kedube/monitoring-pcb/hardware/smoke_bridge/previews/bottom.png

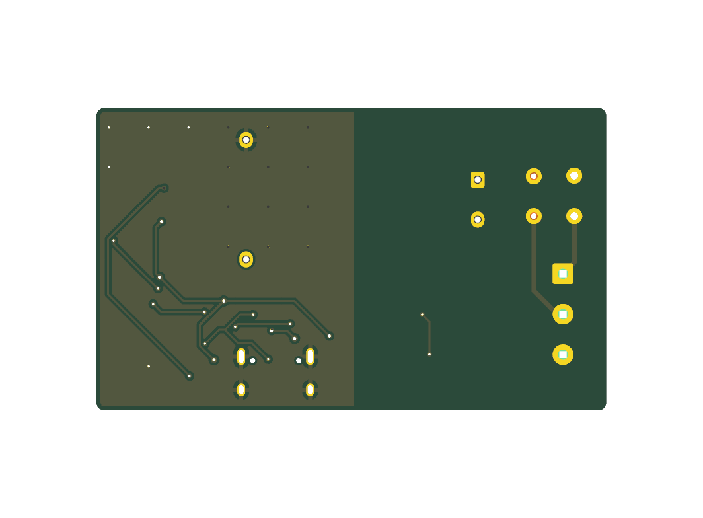
hardware/smoke_bridge/previews/bottom.png
