kedube/monitoring-pcb/hardware/smoke_bridge/previews/review.png

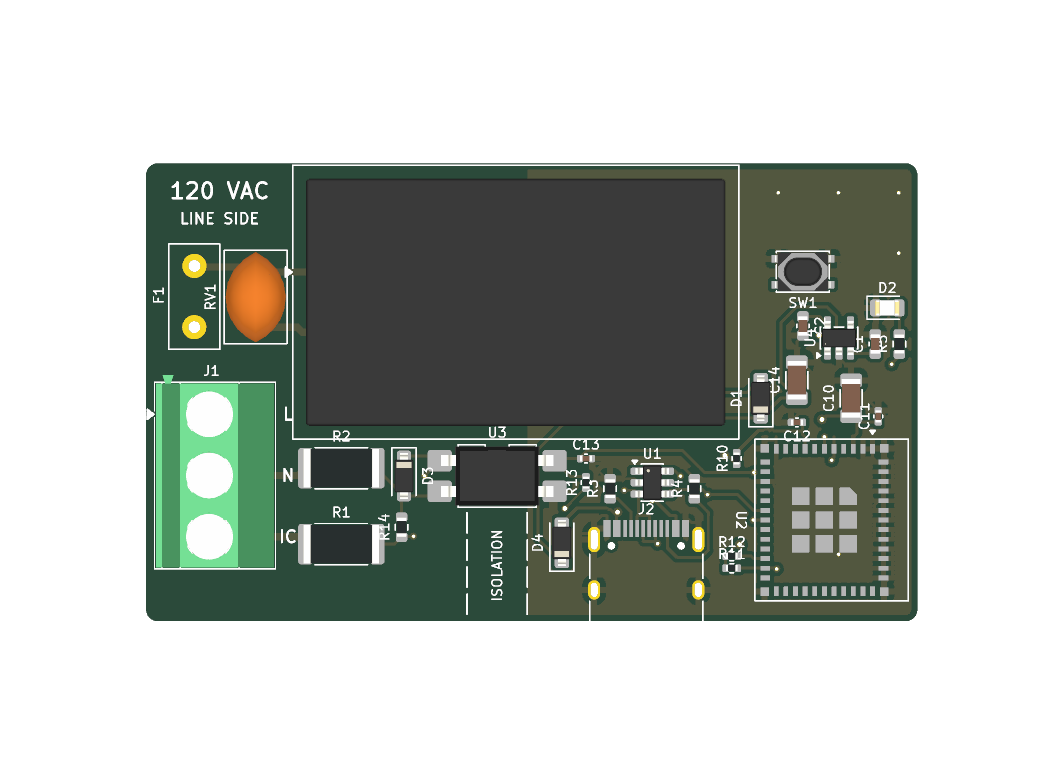
hardware/smoke_bridge/previews/review.png
