kedube/monitoring-pcb/hardware/smoke_bridge/previews/schematic.png

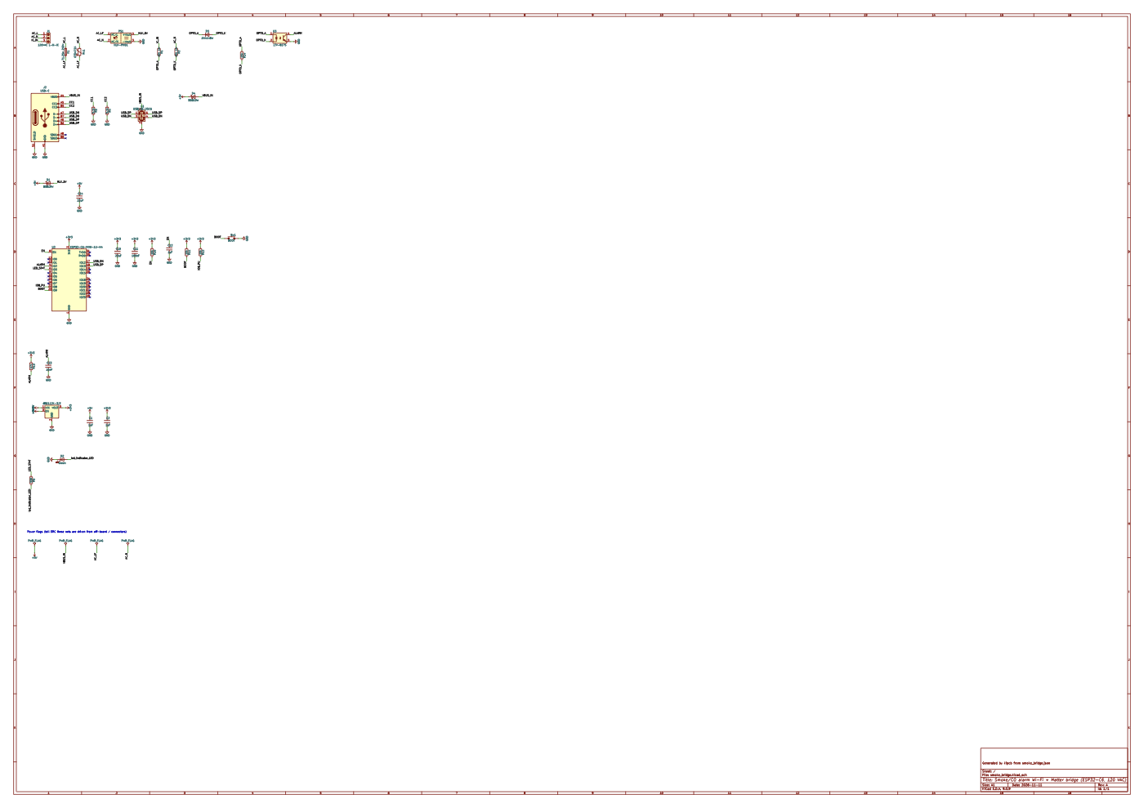
hardware/smoke_bridge/previews/schematic.png
