kedube/monitoring-pcb/hardware/smoke_bridge/fab/smoke_bridge-bom.csv

Comment | Designator | Footprint | LCSC Part # | MPN | Qty
100nF | C11 | C_0402_1005Metric | C307331 |  | 1
1uF | C12 | C_0402_1005Metric | C52923 |  | 1
10nF | C13 | C_0402_1005Metric | C15195 |  | 1
1uF | C1,C2 | C_0603_1608Metric | C15849 |  | 2
22uF | C10,C14 | C_1206_3216Metric | C12891 |  | 2
Green | D2 | LED_0805_2012Metric | C2297 |  | 1
1N4148W | D3 | D_SOD-123 | C81598 |  | 1
B5819W | D1,D4 | D_SOD-123 | C8598 |  | 2
T1.25A 250V | F1 | Fuse_Littelfuse_395Series | C354901 | 2010T1.25A250V | 1
120VAC L-N-IC | J1 | Terminal_3P_5.08_L-N-IC | C430602 | DB128L-5.08-3P-BK-S | 1
USB-C | J2 | USB_C_Receptacle_HRO_TYPE-C-31-M-12 | C165948 |  | 1
HLK-PM01 | PS1 | HLK-PM01_IsolationBarrier | C209903 |  | 1
330 | R5 | R_0603_1608Metric | C23138 |  | 1
47k | R13 | R_0402_1005Metric | C25792 |  | 1
15k | R14 | R_0603_1608Metric | C22809 |  | 1
10k 1W | R1,R2 | R_2512_6332Metric | C25718 |  | 2
10k | R10,R11,R12 | R_0402_1005Metric | C25744 |  | 3
5.1k | R3,R4 | R_0603_1608Metric | C23186 |  | 2
07D471K | RV1 | C_Disc_D7.5mm_W5.0mm_P5.00mm | C49072860 |  | 1
BOOT | SW1 | SW_SPST_PTS810 | C221895 | PTS810SJG250SMTRLFS | 1
USBLC6-2SC6 | U1 | SOT-23-6 | C7519 |  | 1
ESP32-C6-MINI-1U-H4 | U2 | ESP32-C6-MINI-1U | C20627095 |  | 1
LTV-817S | U3 | SMDIP-4_W9.53mm | C109227 | LTV-817S-TA1-C | 1
AP2112K-3.3 | U4 | SOT-23-5 | C51118 |  | 1
