kedube/monitoring-pcb/hardware/smoke_bridge/fab/smoke_bridge.step

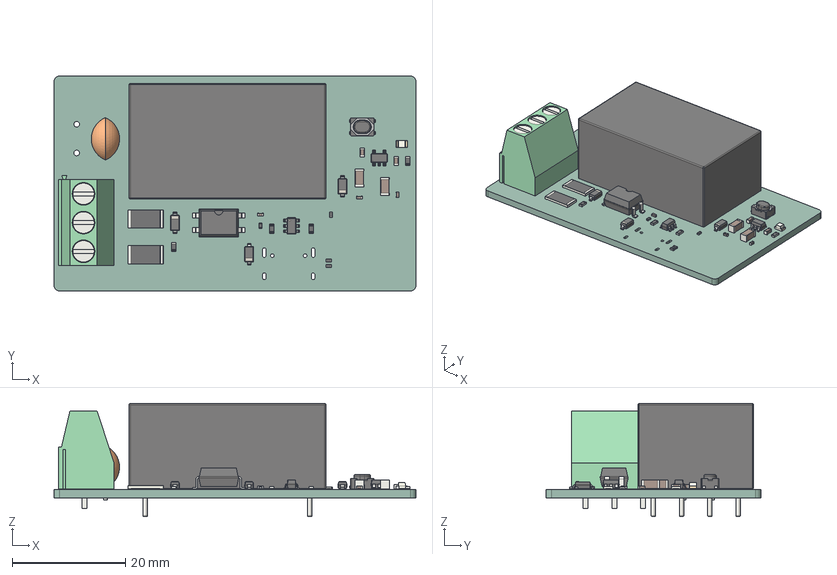
[picture p4: CAD file, 2026-11-12]
hardware/smoke_bridge/fab/smoke_bridge.step
64.0 x 38.0 x 20.0 mm
SW_SPST_PTS810
R_0603_1608Metric x 4
R_2512_6332Metric x 2
D_SOD-123 x 3
R_0402_1005Metric x 4
Converter_ACDC_Hi-Link_HLK-PMxx
C_0402_1005Metric x 3
SMDIP-4_W9.53mm
C_1206_3216Metric x 2
C_0603_1608Metric x 2
C_Disc_D7.5mm_W5.0mm_P5.00mm
SOT-23-5
TerminalBlock_Phoenix_MKDS-1,5-3-5.08_1x03_P5.08mm_Horizontal
SOT-23-6
LED_0805_2012Metric
smoke_bridge_PCB
