kedube/monitoring-pcb/hardware/smoke_bridge/previews/board.pdf

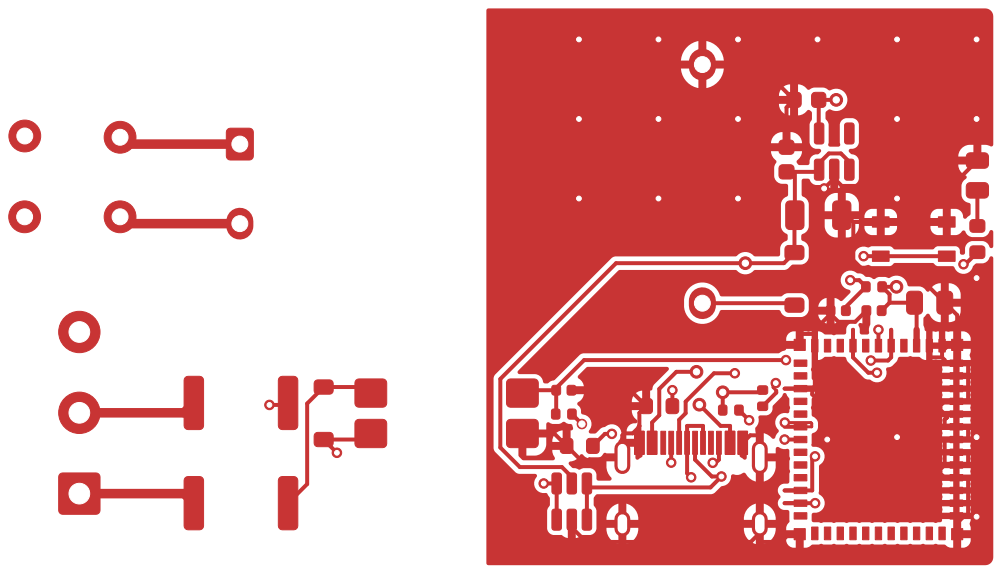
[picture p5: page 1]

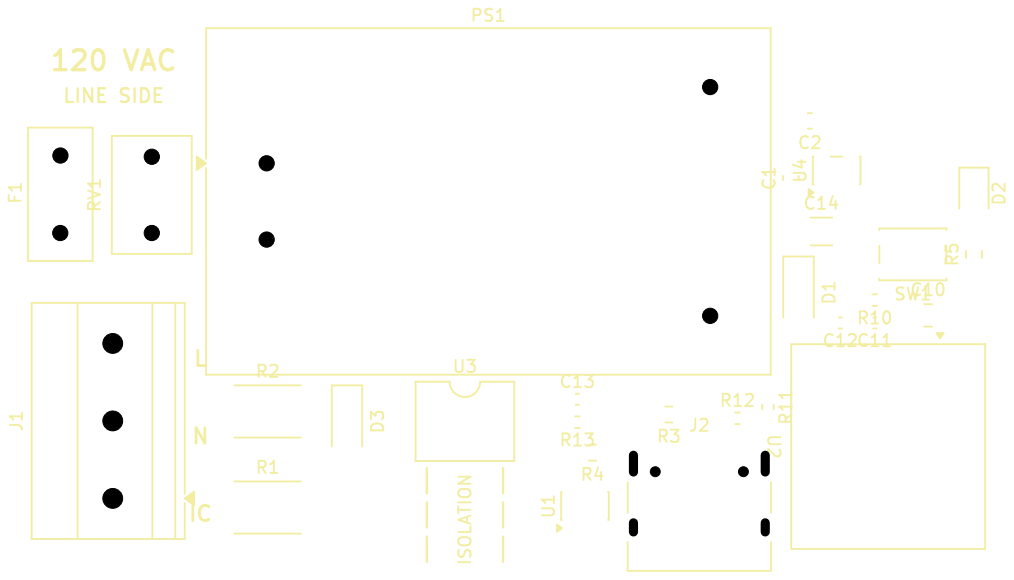
[picture p6: page 2]

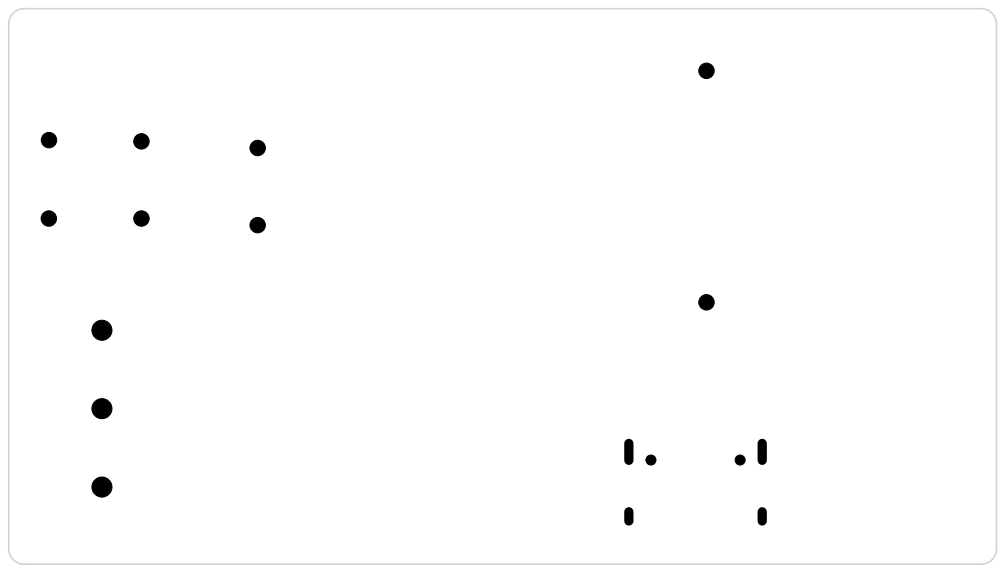
[picture p7: page 3]

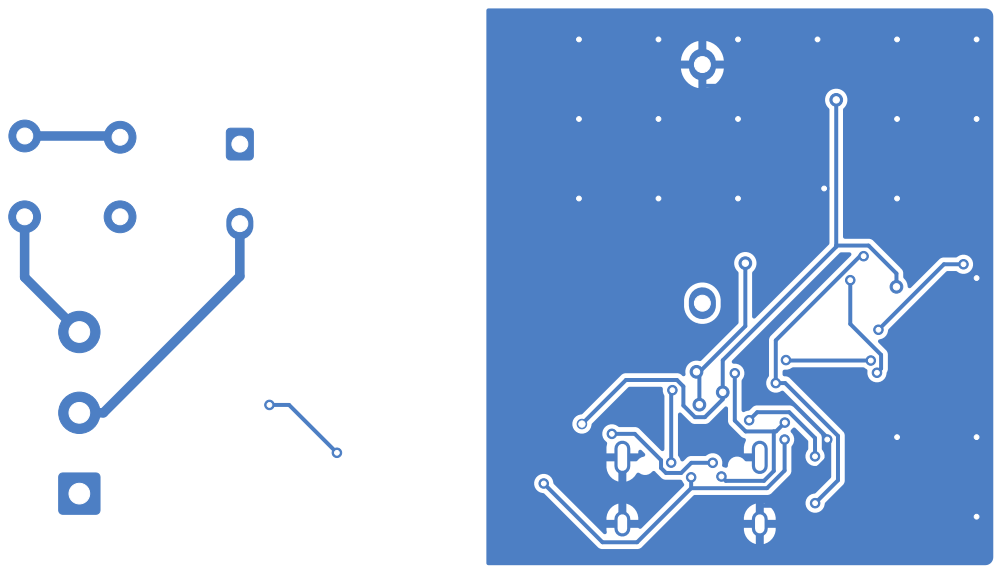
[picture p8: page 4]

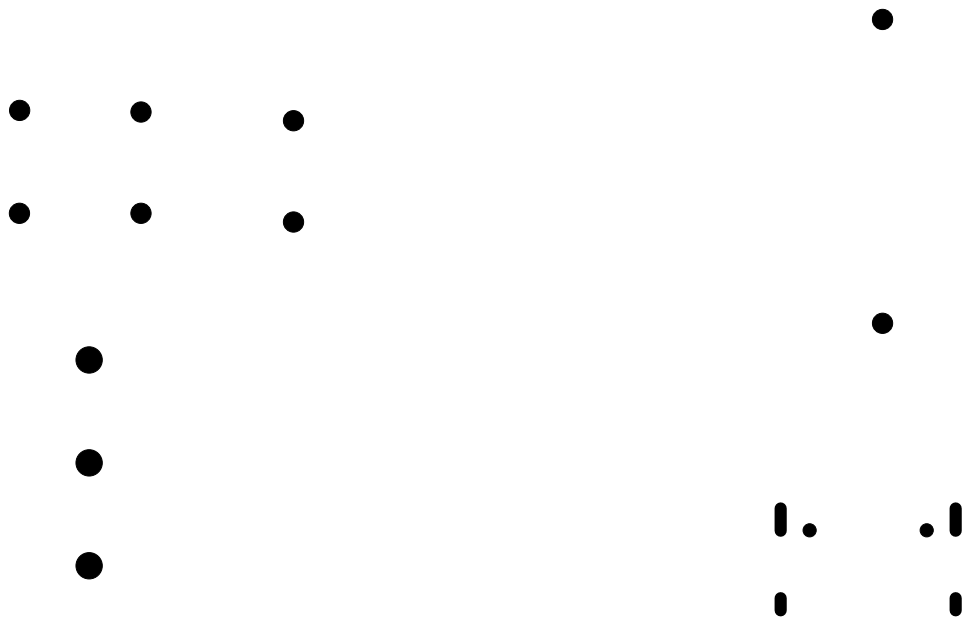
[picture p9: page 5]
