kedube/monitoring-pcb/hardware/smoke_bridge/previews/schematic.pdf

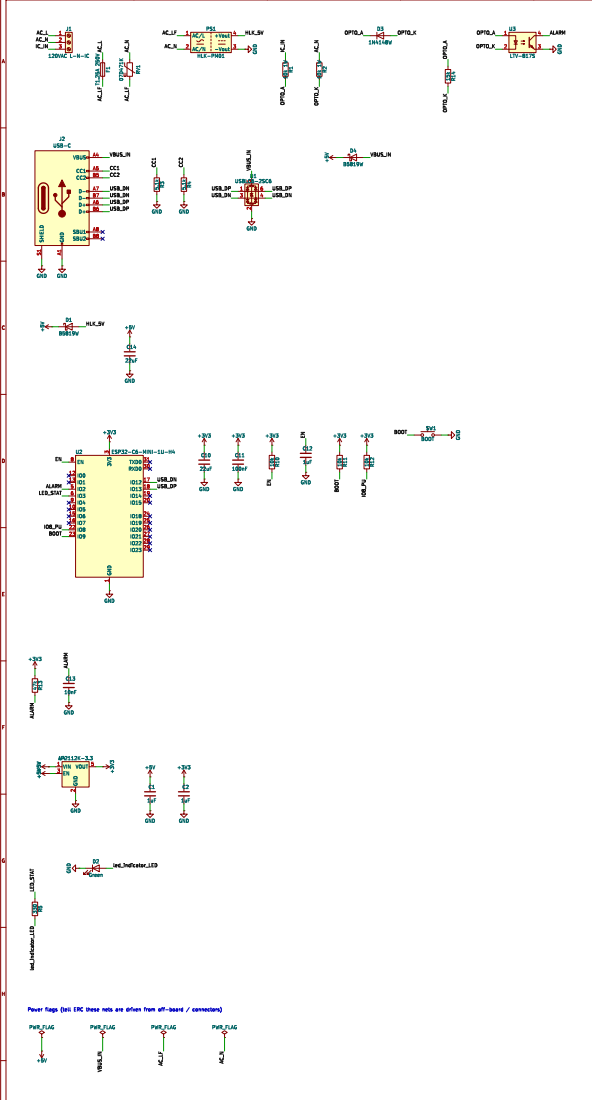
[picture p10: page 1]
