kedube/monitoring-pcb/(list of files, drawings)

Other design files:
hardware/smoke_bridge/.kipcb/smoke_bridge.dsn
