kedube/monitoring-pcb/hardware/smoke_bridge/smoke_bridge.kicad_pcb

## KiCad design hardware/smoke_bridge/smoke_bridge.kicad_pcb (2026-11-12)

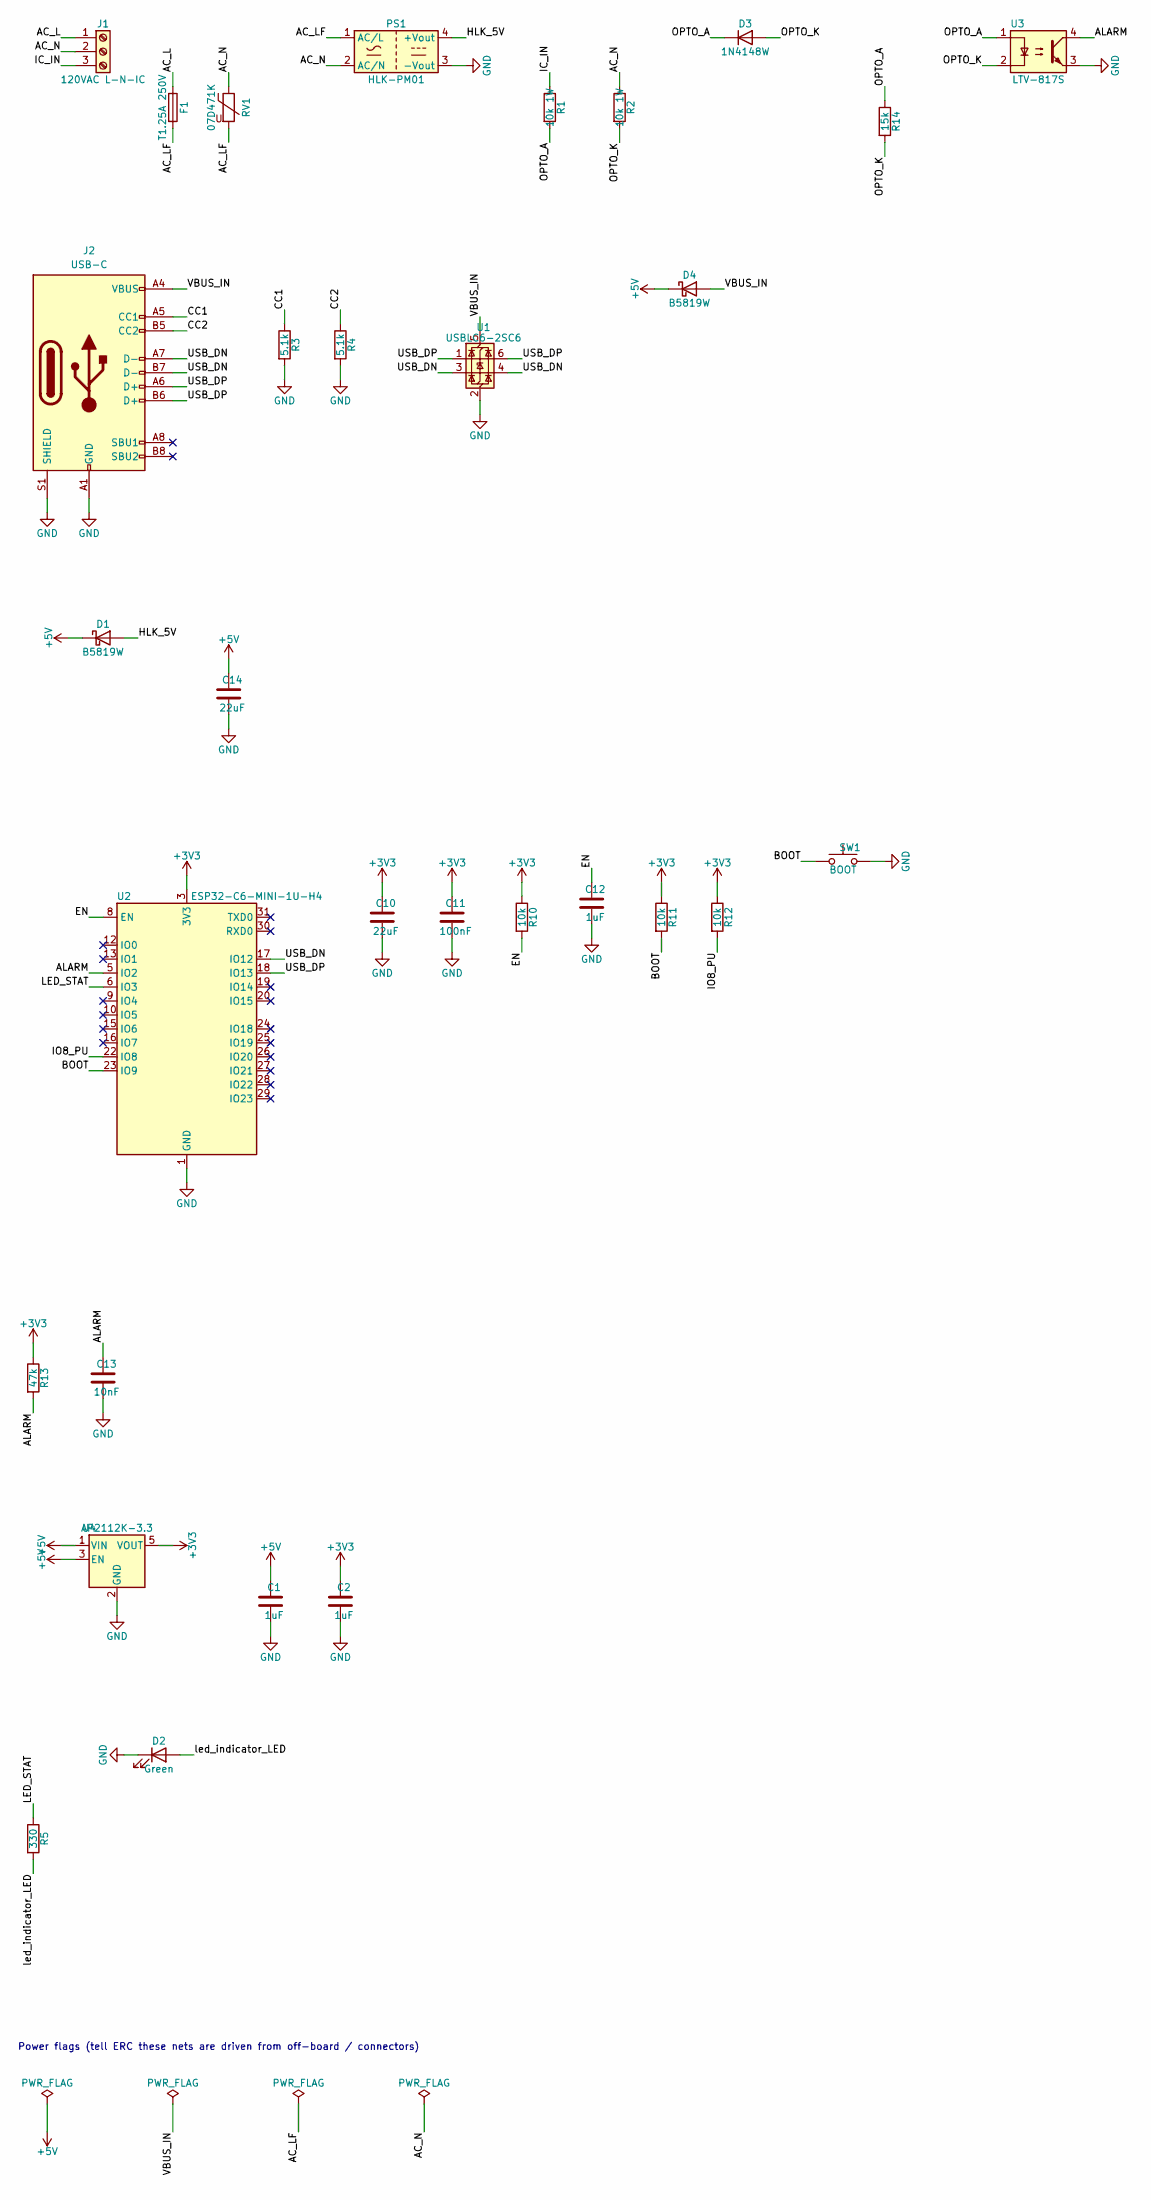
[picture p11: schematic smoke_bridge.kicad_sch, Smoke/CO alarm Wi-Fi + Matter bridge (ESP32-C6, 120 VAC)]

Parts:
C1, C2: 1uF; C_0603_1608Metric; LCSC C15849
C10, C14: 22uF; C_1206_3216Metric; LCSC C12891
C11: 100nF; C_0402_1005Metric; LCSC C307331
C12: 1uF; C_0402_1005Metric; LCSC C52923
C13: 10nF; C_0402_1005Metric; LCSC C15195
D1, D4: B5819W; D_SOD-123; LCSC C8598
D2: Green; LED_0805_2012Metric; LCSC C2297
D3: 1N4148W; D_SOD-123; LCSC C81598
F1: T1.25A 250V; Fuse_Littelfuse_395Series; MPN 2010T1.25A250V; LCSC C354901
J1: 120VAC L-N-IC; Terminal_3P_5.08_L-N-IC; MPN DB128L-5.08-3P-BK-S; LCSC C430602
J2: USB-C; USB_C_Receptacle_HRO_TYPE-C-31-M-12; LCSC C165948
PS1: HLK-PM01; HLK-PM01_IsolationBarrier; LCSC C209903
R1, R2: 10k 1W; R_2512_6332Metric; Voltage 200V; LCSC C25718
R3, R4: 5.1k; R_0603_1608Metric; LCSC C23186
R5: 330; R_0603_1608Metric; LCSC C23138
R10, R11, R12: 10k; R_0402_1005Metric; LCSC C25744
R13: 47k; R_0402_1005Metric; LCSC C25792
R14: 15k; R_0603_1608Metric; LCSC C22809
RV1: 07D471K; C_Disc_D7.5mm_W5.0mm_P5.00mm; LCSC C49072860
SW1: BOOT; SW_SPST_PTS810; MPN PTS810SJG250SMTRLFS; LCSC C221895
U1: USBLC6-2SC6; SOT-23-6; LCSC C7519
U2: ESP32-C6-MINI-1U-H4; ESP32-C6-MINI-1U; LCSC C20627095
U3: LTV-817S; SMDIP-4_W9.53mm; MPN LTV-817S-TA1-C; LCSC C109227
U4: AP2112K-3.3; SOT-23-5; LCSC C51118

Connections:
+3V3: C2.1, C10.1, C11.1, R10.1, R11.1, R12.1, R13.1, U2.3 (3V3), U4.5 (VOUT)
+5V: C1.1, C14.1, D1.1 (K), D4.1 (K), U4.1 (VIN), U4.3 (EN)
/AC_L: F1.1, J1.1
/AC_LF: F1.2, PS1.1 (AC/L), RV1.2
/AC_N: J1.2, PS1.2 (AC/N), R2.1, RV1.1
/ALARM: C13.1, R13.2, U2.5 (IO2), U3.4
/BOOT: R11.2, SW1.1, U2.23 (IO9)
/CC1: J2.A5 (CC1), R3.1
/CC2: J2.B5 (CC2), R4.1
/EN: C12.1, R10.2, U2.8 (EN)
/HLK_5V: D1.2 (A), PS1.4 (+Vout)
/IC_IN: J1.3, R1.1
/IO8_PU: R12.2, U2.22 (IO8)
/LED_STAT: R5.1, U2.6 (IO3)
/OPTO_A: D3.1 (K), R1.2, R14.1, U3.1
/OPTO_K: D3.2 (A), R2.2, R14.2, U3.2
/USB_DN: J2.A7 (D-), J2.B7 (D-), U1.3 (I/O2), U1.4 (I/O2), U2.17 (IO12)
/USB_DP: J2.A6 (D+), J2.B6 (D+), U1.1 (I/O1), U1.6 (I/O1), U2.18 (IO13)
/VBUS_IN: D4.2 (A), J2.A4 (VBUS), J2.A9 (VBUS), J2.B4 (VBUS), J2.B9 (VBUS), U1.5 (VBUS)
/led_indicator_LED: D2.2 (A), R5.2
GND: C1.2, C2.2, C10.2, C11.2, C12.2, C13.2, C14.2, D2.1 (K), J2.A1 (GND), J2.A12 (GND), J2.B1 (GND), J2.B12 (GND), J2.S1 (SHIELD), PS1.3 (-Vout), R3.2, R4.2, SW1.2, U1.2 (GND), U2.1 (GND), U2.2 (GND), U2.11 (GND), U2.14 (GND), U2.36 (GND), U2.37 (GND), U2.38 (GND), U2.39 (GND), U2.40 (GND), U2.41 (GND), U2.42 (GND), U2.43 (GND), U2.44 (GND), U2.45 (GND), U2.46 (GND), U2.47 (GND), U2.48 (GND), U2.49 (GND), U2.50 (GND), U2.51 (GND), U2.52 (GND), U2.53 (GND), U3.3, U4.2 (GND)

Notes on the sheet:
Power flags (tell ERC these nets are driven from off-board / connectors)

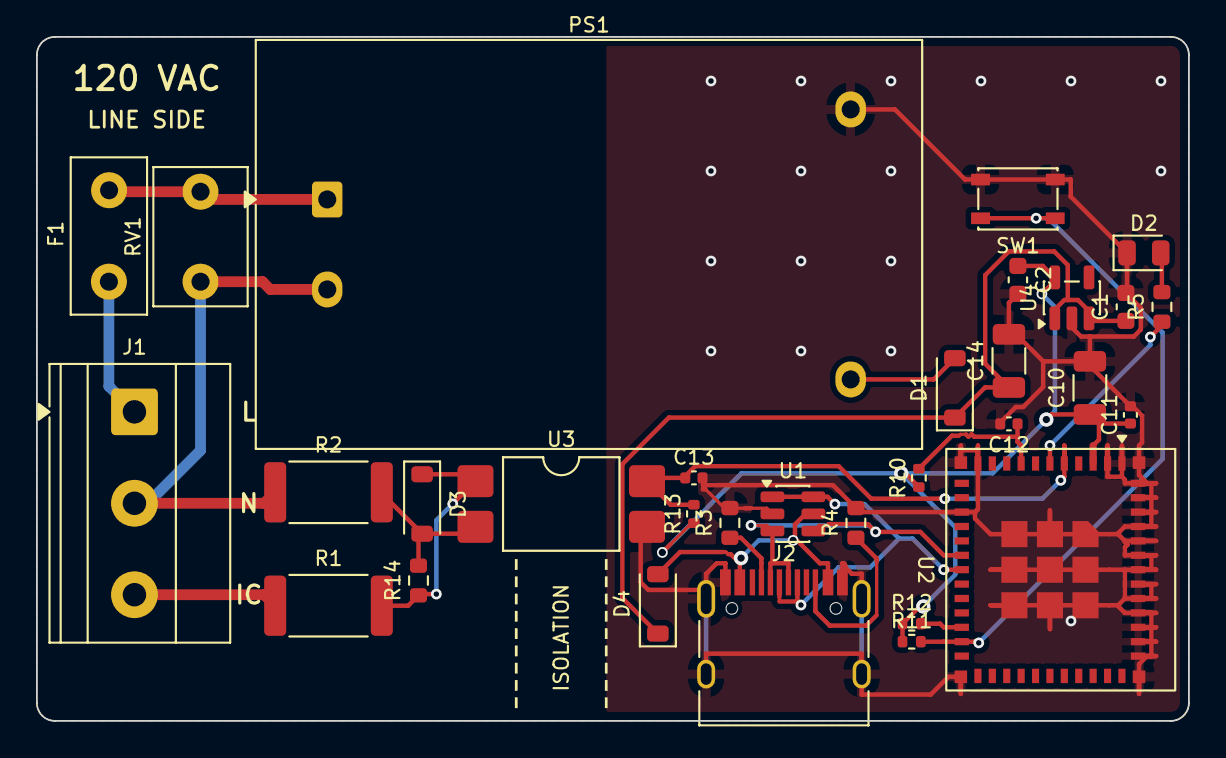
[picture p12: board smoke_bridge.kicad_pcb from above]

Board: 2 copper layers, 64.0 x 38.0 mm, 31 parts (0 on the bottom side), 21 nets.
